NicolasAuersvalt/CriminalPlotter/imagens/000.png

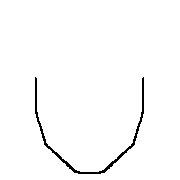
imagens/000.png
