NicolasAuersvalt/CriminalPlotter/imagens/100.png

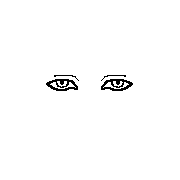
imagens/100.png
