NicolasAuersvalt/CriminalPlotter/imagens/200.png

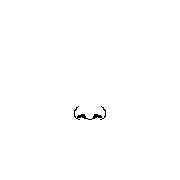
imagens/200.png
