NicolasAuersvalt/CriminalPlotter/imagens/300.png

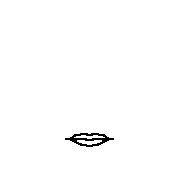
imagens/300.png
