NicolasAuersvalt/CriminalPlotter/imagens/400.png

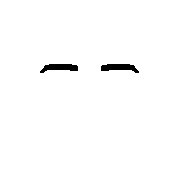
imagens/400.png
