NicolasAuersvalt/CriminalPlotter/imagens/402.png

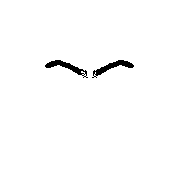
imagens/402.png
