NicolasAuersvalt/CriminalPlotter/imagens/500.png

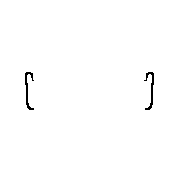
imagens/500.png
