NicolasAuersvalt/CriminalPlotter/imagens/600.png

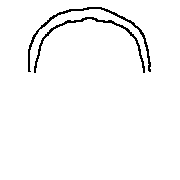
imagens/600.png
