NicolasAuersvalt/CriminalPlotter/imagens/601.png

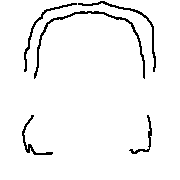
imagens/601.png
