NicolasAuersvalt/CriminalPlotter/imagens/602.png

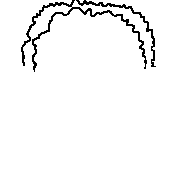
imagens/602.png
