NicolasAuersvalt/CriminalPlotter/images/desenhos nicolas/300x300.png

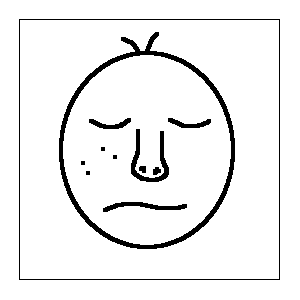
images/desenhos nicolas/300x300.png
