NicolasAuersvalt/CriminalPlotter/impressao/analisado/1.png

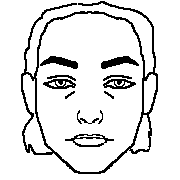
impressao/analisado/1.png
