NicolasAuersvalt/CriminalPlotter/impressao/analisado/8.png

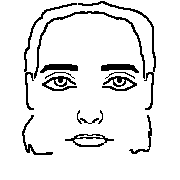
impressao/analisado/8.png
