NicolasAuersvalt/CriminalPlotter/impressao/Banco de Retratos/7.png

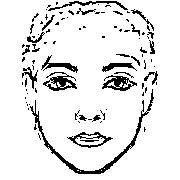
impressao/Banco de Retratos/7.png
