NicolasAuersvalt/CriminalPlotter/impressao/Banco de Retratos/8.png

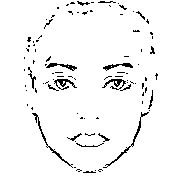
impressao/Banco de Retratos/8.png
