NicolasAuersvalt/CriminalPlotter/impressao/bancoRetratos/4.png

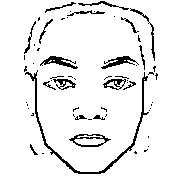
impressao/bancoRetratos/4.png
