NicolasAuersvalt/CriminalPlotter/impressao/bancoRetratos/12.png

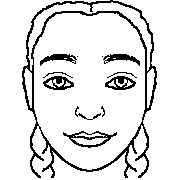
impressao/bancoRetratos/12.png
