NicolasAuersvalt/CriminalPlotter/impressao/bancoRetratos/25.png

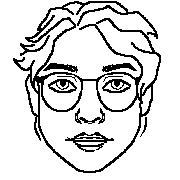
impressao/bancoRetratos/25.png
