NicolasAuersvalt/CriminalPlotter/impressao/bancoRetratos/26.png

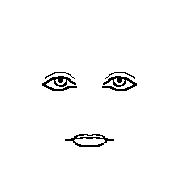
impressao/bancoRetratos/26.png
