NicolasAuersvalt/CriminalPlotter/impressao/bancoRetratos/27.png

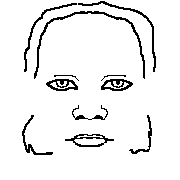
impressao/bancoRetratos/27.png
