NicolasAuersvalt/CriminalPlotter/impressao/bancoRetratos/28.png

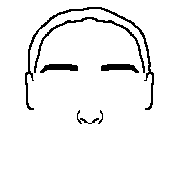
impressao/bancoRetratos/28.png
