NicolasAuersvalt/CriminalPlotter/impressao/bancoRetratos/30.png

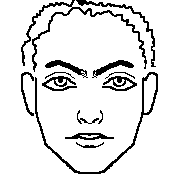
impressao/bancoRetratos/30.png
