NicolasAuersvalt/CriminalPlotter/impressao/bancoRetratos/31.png

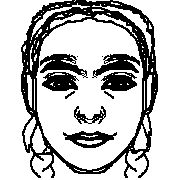
impressao/bancoRetratos/31.png
