NicolasAuersvalt/CriminalPlotter/impressao/bancoRetratos/32.png

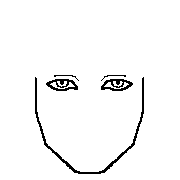
impressao/bancoRetratos/32.png
