NicolasAuersvalt/CriminalPlotter/impressao/bancoRetratos/33.png

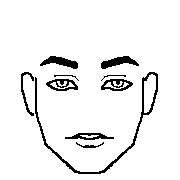
impressao/bancoRetratos/33.png
